josemsotov/Smart-trolley-AGO26-arduino-bridge-15/portfolio/index.html

Skip to project

SR SOTO-ROBOTICS Toggle navigation

01 SOTO-ROBOTICS R&D case study

# Smart Golf Trolley

A multidisciplinary robotic platform developed by SOTO-ROBOTICS to explore safe autonomous assistance on the golf course—from motor control and sensing to ROS 2 perception and a field-ready operator interface.

Explore the engineering ↓ Contact Jose ↗

- ROS 2Jazzy robotics stack
- 2-layerEmbedded + edge control
- Safety-ledFail-safe architecture

01 Dual LiDAR

02 RGB-D vision

03 Differential drive

Prototype development / active validation

Embedded systemsRoboticsElectronicsMechanical integrationPerceptionTest & validation Embedded systemsRoboticsElectronicsMechanical integration

02 Project overview

## Turning a trolley into a robotic platform

The objective was not simply to motorise a golf trolley. It was to create an extensible engineering platform capable of manual operation, person-following research, environmental sensing and future autonomous navigation—without losing sight of real-world safety.

The work brings together a differential-drive chassis, low-level AVR firmware, a Raspberry Pi 5 running ROS 2, multi-sensor perception, live telemetry and a purpose-built web console.

Development follows an incremental R&D process: model, integrate, bench-test, measure, diagnose and only then advance towards controlled ground trials.

01

### The challenge

Coordinate motors, noisy wheel feedback and diverse sensors across two computing layers while maintaining predictable stop behaviour.

02

### The approach

Separate deterministic hardware control from high-level robotics, connect them through a validated serial protocol and test each layer independently.

03

### The outcome

An integrated prototype with manual drive, telemetry, fused odometry, perception experiments, simulation and layered safety controls.

03 Engineering scope

## One project. Four disciplines.

01

</>

### Software & autonomy

Developed a modular Arduino C++ control layer and a ROS 2 Jazzy stack for command routing, odometry, localisation experiments, person-following and operator control.

- C++ / Arduino
- Python
- ROS 2 Jazzy
- Nav2
- Gazebo
- FastAPI

02

⚛

### Electronics & sensing

Integrated dual motor actuation with Hall and optical encoder feedback, IMU, current monitoring, GPS, RGB-D vision, upper LiDAR and a 90 FPS global-shutter camera. A second low-mounted LiDAR was prototyped and is currently displaced by the swing camera.

- Mega 2560
- Raspberry Pi 5
- MPU IMU
- ACS712
- Kinect RGB-D
- LD19 LiDAR
- ELP 90 FPS camera

03

◎

### Mechanical integration

Configured a differential-drive layout around 270 mm wheels and passive casters, then defined the robot geometry, sensor frames and collision model for physical integration and simulation.

- Drive layout
- Sensor mounting
- Wheel geometry
- URDF / Xacro
- Packaging
- Service access

04

✓

### Systems validation

Created dedicated diagnostics, repeatable encoder sweeps, motor bench routines, simulation scenarios and live dashboards to expose faults before autonomous operation.

- Bench testing
- Calibration
- Telemetry
- Fault injection
- Simulation
- Traceable results

04 Mechanical integration

## Robotics engineered around an off-the-shelf trolley

The mechanical strategy retains the practical structure of a commercially available trolley and adds purpose-designed interfaces where standard hardware cannot meet the robotic requirements.

Custom 3D-printed parts provide a rapid, adaptable route for mounting sensors, routing cables, housing electronics and aligning components. This hybrid approach reduces fabrication time while allowing the robotic package to evolve through repeated physical trials.

PHOTO 01 Full trolley overview Final project photography to be added

01

Platform integration

Overall view showing how the robotic system is incorporated into the original trolley structure.

PHOTO 02 3D-printed interfaces Mount and enclosure close-ups

02

Custom adaptation

Printed brackets and enclosures bridge the geometry between sensors, electronics and the donor trolley.

PHOTO 03 Electronics packaging Wiring and service access

03

Serviceable assembly

Controller, power and sensor connections arranged for inspection, iteration and fault finding.

01

### Reuse the proven base

The off-the-shelf trolley contributes an established frame, wheel arrangement and load-carrying function, concentrating development effort on robotic capability.

02

### Adapt without permanent tooling

3D printing enables fast geometry changes as sensor positions, cable routes and component selections are refined during prototype testing.

03

### Design for maintenance

Modular mounts and accessible electronics support inspection, replacement and controlled experimentation across the evolving platform.

05 System architecture

## Designed in layers

Time-critical motor and safety functions stay close to the hardware. Compute-intensive perception, supervision and operator tooling run on the edge computer.

Human interface

### Operator

Stadia controller
Responsive web console
Emergency stop

Commands

High-level compute

### Raspberry Pi 5

ROS 2 orchestration
Perception & following
Odometry & telemetry

115.2 kbaud

Real-time interface

### Arduino Mega

Motor PWM & direction
Encoder acquisition
Watchdog & limits

Perception

### RGB-D + dual LiDAR

Visual tracking and 2D ranging provide complementary environmental observations for follower and obstacle-gating research.

Motion feedback

### Hall + optical fusion

Two encoder technologies are compared in a shared 45 PPR domain, with weighted fusion and fail-safe fallback when they disagree.

Vehicle state

### IMU + current + GPS

Orientation, motor load and position data enrich diagnostics and support heading, localisation and protection functions.

06 Systems engineering

## From stakeholder need to verified behaviour

The trolley is treated as a system of people, software, electronics, mechanics, information and operating procedures—not as a collection of components.

A V-model and MBSE-inspired workflow connects operational needs to functions, logical architecture, physical implementation, interfaces and verification evidence. The artefacts below are reconstructed from the implemented prototype and its test record.

Scope statement: this is a preliminary engineering baseline for an R&D prototype. It is not an ISO 26262 assessment, product certification, safety case or permission for unsupervised operation.

01

### Need & CONOPS

Assist a golfer by carrying equipment, following or accepting manual commands while remaining observable and controllable during field trials.

02

### Requirements

Translate the need into measurable motion, perception, control-authority, stopping, telemetry and maintainability requirements.

03

### Functional analysis

Decompose the mission into operate, perceive, decide, move, protect, estimate, inform, verify and support functions.

04

### Architecture & interfaces

Allocate functions across the operator, web HMI, ROS 2 edge computer, embedded controller, sensors and mechanical plant.

05

### Integration & V&V

Integrate bottom-up, exercise interfaces, inject stale or invalid inputs and retain test results as objective evidence.

A System context

### Functional and physical allocation

Commands flow left to right; state, diagnostics and evidence return to the operator. The boundary includes the robot and its local edge-compute stack.

Stakeholders

#### People & external systems

- Golfer / operator
- Test engineer
- Maintainer
- Home Assistant

intent

Interaction

#### Control & information

- Physical Stadia controller
- Fairway Trolley OS
- STOP and mode requests
- Telemetry / maps / media

HTTP · evdev

Edge compute

#### Raspberry Pi 5 / ROS 2

- Authority & velocity mux
- Follower / gesture / navigation
- Odometry, EKF & perception
- Web API and observability

USB serial

Embedded control

#### Arduino Mega 2560

- Command validation & watchdog
- Differential drive conversion
- Sensor acquisition
- PWM / direction / brake / stop

I/O · power

Physical plant

#### Trolley & environment

- Two driven wheels
- Passive casters and chassis
- Golf equipment payload
- People, terrain and obstacles

Feedback path Hall + optical encodersIMUmotor currentGPSRGB-Ddual LiDAR

B Control architecture

### One authorised motion path

Multiple behaviours may propose motion, but a single arbiter selects and limits one fresh source before commands cross the embedded boundary.

Command sources

Web dead-manFresh while held

Physical StadiaManual takeover

FollowerAuthorised person track

GestureExplicit mode

Nav2Readiness + GPS gated

1Field supervisorFail-closed mode selection

2cmd_vel muxFreshness, priority and ±0.45 m/s / ±0.90 rad/s clamps

3Arduino bridge0.5 s command watchdog and serial validation

4FirmwareVelocity constraints, 1.0 s ROS timeout, heading and motor state

5ActuationTimer5 PWM, direction, brake and driver STOP lines

C

### Functional allocation

Operate

Modes, manual drive, web dead-man, speed limits and emergency request.

HMI + Stadia + field supervisor

Perceive

Person, face session, obstacles, depth, pose and high-speed swing observations.

Kinect + upper LiDAR + ELP global shutter + Coral

Decide

Control authority, target association, obstacle gating and navigation readiness.

ROS 2 supervision and behaviours

Move

Differential velocity conversion, heading correction and motor actuation.

Bridge + Arduino firmware + drivers

Estimate

Wheel odometry, encoder confidence, IMU state, GPS and mapping.

Encoder fusion + EKF + SLAM

Protect

Source timeout, command clamps, stop states, takeover and perception freshness.

Distributed software controls

Inform & verify

Live telemetry, health, maps, diagnostics, media and recorded test results.

Fairway OS + Python test tools

D

### Lifecycle evidence

1. NeedSafe robotic assistance concept
2. RequirementsDerived operating and safety baseline
3. Logical designFunctions, modes and authority model
4. Physical designPi, Mega, sensors, drivers and chassis
5. Component verificationMotor, Hall, optical, IMU, current and serial tools
6. Integration verificationROS tests, interface checks and bench sweeps
7. System validationControlled ground trials remain incomplete

Traceability rule

Need → requirement → function → component/interface → verification method → result. The current repository contains substantial test evidence, but not yet a complete approved RTM.

E Interface control

### Defined exchanges across boundaries

ID | Boundary | Exchange | Protocol / physical interface | Control or constraint
IF-01 | Operator ↔ Fairway OS | Modes, STOP, limits, telemetry, map and media | HTTP, WebSocket, responsive browser | Web joystick is dead-man; loss of fresh packets returns zero
IF-02 | Home Assistant ↔ Fairway OS | Canonical operator interface | HTTP iframe | One UI implementation; HA authentication does not protect the direct Pi URL
IF-03 | Stadia ↔ Pi | Drive axes, takeover and safety buttons | Bluetooth / Linux evdev | Takeover on connect; configured deadzones; current deployed profile does not require neutral-to-arm
IF-04 | ROS 2 nodes | Commands, state, images, scans and transforms | DDS over Zenoh; ROS topics / TF | Single output mux; source freshness and mode authority
IF-05 | Pi ↔ Arduino | Velocity, raw diagnostics and telemetry | USB ASCII serial at 115,200 baud | Line validation, bounded raw command length and independent timeouts
IF-06 | Arduino ↔ motor drivers | PWM, direction, brake and STOP | Timer5 + digital I/O | Pin-specific implementation; pin 44 requires direct OCR5C handling
IF-07 | Wheels ↔ Arduino | Rotation pulses | Hall + optical interrupts, 45 effective PPR | Hall-primary confidence logic; optical-only motion is rejected
IF-08 | IMU ↔ Arduino | Acceleration, rate, pitch and yaw | I2C, 200 Hz target | Filtering, calibration and heading feedback; tilt logic exists
IF-09 | Power path ↔ Arduino | Left/right motor current | ACS712 analogue inputs | Telemetry implemented; automatic overcurrent trip not evidenced
IF-10 | GPS ↔ Arduino/Pi | Fix, satellites and position | Serial3 at 9,600 baud / ROS NavSatFix | Navigation gated by freshness, fix and quality; antenna transform remains provisional
IF-11 | Kinect ↔ Pi | RGB, depth, body, face and tilt | USB / ROS image topics | Freshness and identity gates; not a safety-rated perception channel
IF-12 | LD19 ↔ Pi | Upper 2D range scan; provision for a lower scan | USB serial at 230,400 baud / LaserScan | Upper scan supports behaviour; the lower unit is currently disconnected and disabled
IF-13 | TF-Luna provision | Short-range distance | I2C 0x10 / 0x11 via 3.3 V adaptation | Compiled support, disabled at boot and not credited for stopping
IF-14 | ELP camera ↔ Pi | Live framing and high-speed swing video | Direct USB / V4L2 MJPEG; 640×480 preview and 1920×1080 capture at 90 FPS | Preview releases the device for a bounded 15 s master capture, then resumes while the H.264 review proxy is generated; analysis evidence only, not a safety channel

F Provisional requirements baseline

### Measurable statements and verification intent

These requirements are derived from implemented behaviour and recorded configuration. They should be reviewed with stakeholders and placed under formal change control.

ID | Provisional system requirement | Allocation | Verification | Current evidence
SYS-01 | The system shall default to a non-moving state when no authorised fresh command source is available. | Supervisor, mux, bridge, firmware | Fault injection / timeout test | Implemented; multi-layer timeout evidence, full chain timing TBC
SYS-02 | The system shall constrain commanded velocity to the approved prototype operating envelope. | Mux, Stadia node, firmware | Boundary-value test | ROS unit tests verify ±0.45 m/s and ±0.90 rad/s mux clamps
SYS-03 | The operator shall be able to cancel autonomous following through deliberate physical-controller input. | Stadia node, supervisor | Integration test | Takeover and authorisation revocation implemented
SYS-04 | Follower motion shall require a connected controller, explicit authorisation, fresh follower state and an enabled person track. | Supervisor, Stadia, follower | State-transition test | Fail-closed selection has automated tests
SYS-05 | Forward follower motion shall be inhibited when required obstacle observations are stale, unknown or blocked. | Follower obstacle gate | Unit + controlled obstacle test | Core unit tests pass; physical coverage and stopping distance TBC
SYS-06 | The system shall report command, motor, encoder, IMU, GPS, perception and service freshness to the operator. | Bridge, web server, HMI | Interface inspection | Live WebSocket dashboard implemented
SYS-07 | The embedded controller shall set motor demand to zero within 1.0 s of a lost ROS velocity command. | Arduino firmware | Timed disconnect test | Firmware timeout implemented; measured end-to-end stop TBC
SYS-08 | The system shall preserve diagnostic evidence sufficient to reproduce calibration and integration decisions. | Test tools and repository | Configuration audit | Extensive records exist; formal configuration baseline remains incomplete

G Preliminary safety engineering

### Credit controls only when evidence supports them

The assessment uses qualitative severity and likelihood for prioritisation. ISO 26262 HARA concepts inform the structure, but ASIL is deliberately not assigned: this trolley is not being assessed as a road-vehicle item, operational exposure is not quantified, and controllability data is unavailable.

SF-01 · credited prototype control

#### Fail-closed command chain

Mode gating, single-source arbitration, source freshness, Pi watchdog and firmware timeout drive demand to zero after communication loss.

Evidence: code + ROS unit tests. End-to-end stopping time and distance still require measurement.

SF-02 · credited prototype control

#### Manual takeover

Physical Stadia movement revokes follower authorisation, sends zero and transfers authority to manual control.

Evidence: implemented logic. Human-factors validation remains open.

SF-03 · credited prototype control

#### Velocity limiting and ramping

Command clamps, deadzones, acceleration/deceleration ramps and stop-before-reversal reduce abrupt or excessive demand.

Evidence: configuration + unit tests. Safe limits depend on mass, slope and surface.

SF-04 · partial credit

#### Obstacle and target gating

Follower logic requires fresh LiDAR/depth observations and uses target continuity and visual identity checks.

Gap: blind zones, environmental performance and physical stopping distance are not validated.

SF-05 · monitoring only

#### Velocity guard and current sensing

The guard detects conflicting publishers, motion while stopped and limit violations; ACS712 channels expose motor current.

Gap: the configured guard is monitor-only and no automatic overcurrent shutdown is evidenced.

SF-06 · not credited

#### Tilt / balance response

Firmware contains tilt thresholds, correction and emergency-stop logic, but the production ROS controller repeatedly commands balance off.

Gap: behaviour is not a validated safety function in the deployed operating configuration.

SF-07 · not evidenced

#### Independent emergency stop

The red web STOP and software stop chain are useful operational controls.

Gap: no independent hardwired mushroom, safety relay or motor-power contactor is evidenced in the reviewed baseline.

Preliminary risk priority CriticalHighMediumLow

Priority combines credible harm severity with qualitative likelihood before additional mitigation. It is not an ASIL or certified risk rating.

ID | Hazardous event | Potential effect | Existing controls | Key gap / recommended action | Priority
HZ-01 | Unintended motion or failure to stop | Impact, trapping or trolley runaway | Authority model, mux zero, multiple watchdogs, software STOP | Add independent hardwired E-stop and power isolation; measure worst-case stop time/distance on representative load and slope | Critical
HZ-02 | Forward collision during follower operation | Person struck or equipment/property damage | Upper LiDAR, depth freshness, obstacle gate, speed limit | Validate field of view, detection probability and braking envelope across clothing, sunlight, rain and terrain | High
HZ-03 | Reverse or low-obstacle collision | Foot/ankle impact, caster obstruction or tip | Unknown-rear logic can inhibit retreat in obstacle core | Integrate and validate lower/rear sensing or contact bumpers; the prototype lower LiDAR is currently displaced | High
HZ-04 | Wrong-person acquisition or target jump | Unexpected trajectory into people or hazards | Face session, visual/LiDAR gating, continuity checks, controller authorisation | Quantify false accept/switch rates; require safe reacquisition and operator confirmation after track loss | High
HZ-05 | Tip, rollaway or unstable behaviour on slope | Crush/impact, damaged equipment | Low speed, IMU telemetry, firmware tilt logic | Define slope/payload limits, centre-of-gravity envelope, parking restraint and validated static/dynamic stability tests | High
HZ-06 | Electrical overcurrent, short circuit or battery thermal event | Fire, burns or loss of control | Current telemetry; motor-driver stop lines | Confirm battery chemistry, BMS, fuse, contactor, cable protection, enclosure and automatic trip architecture | Critical
HZ-07 | Unauthorised or malformed network command | Unexpected mode or motion request | Input ranges, source mux and local-network deployment | Add authenticated API, TLS or trusted reverse proxy; restrict raw diagnostics and segment the robot network | High
HZ-08 | Sensor data stale, biased or geometrically misregistered | Incorrect localisation, obstacle decision or heading | Freshness checks, confidence logic and TF model | Complete sensor calibration, lower-LiDAR pose and GPS antenna transform; add plausibility/fault-injection tests | High
HZ-09 | Unexpected movement during maintenance or diagnostic test | Hand injury, impact or entanglement | Warnings, explicit test modes, zero defaults and documented bench practice | Use keyed maintenance enable, wheel-off-ground fixture, exclusion zone and two-person test procedure | High

H

### Risk-reduction roadmap

1. Hardware safe stateDefine and implement independent E-stop, power isolation, braking behaviour and restart interlock.
2. Motion envelopeMeasure loaded stopping distance, slope stability, traction and caster behaviour; derive validated limits.
3. Protective sensingClose rear/low-obstacle coverage and validate perception under representative outdoor conditions.
4. Electrical protectionBaseline battery/BMS/fusing/contactors, current trip thresholds, thermal monitoring and wiring protection.
5. Secure control planeAuthenticate remote commands, isolate diagnostic routes and document the trust boundary.
6. Safety evidenceCreate an approved requirements traceability matrix, interface control documents, hazard log and witnessed V&V procedures.

I

### Assumptions & TBC register

No unsupported value is treated as fact. The following must be measured or confirmed before detailed design limits can be justified:

- Total mass, payload range and centre of gravity
- Motor, gearbox, driver and braking ratings
- Battery chemistry, capacity and protection architecture
- Maximum slope, cross-slope, surface and weather envelope
- Stopping distance and fault-tolerant time interval
- Full sensor coverage, blind zones and environmental limits
- Mechanical strength, ingress protection and EMC performance
- Mission duration, duty cycle, service life and reliability target
- Operator population, training and controllability evidence
- Applicable product, machinery, radio and battery regulations

07 Software design

## From a deterministic loop to a robotics ecosystem

CONTROL_FLOW.cpp

01  read_serial_commands();
02  update_imu_and_current();
03
04  if (command_is_fresh) {
05    constrain_velocity();
06    apply_heading_correction();
07    drive_differential_motors();
08  } else {
09    safe_stop();
10  }
11
12  publish_telemetry();

01

### Modular firmware

Compile-time feature flags keep the AVR build configurable while a cooperative superloop avoids blocking the safety path.

02

### ROS 2 command supervision

A velocity multiplexer separates manual, gesture, follower and navigation sources so control authority is explicit.

03

### Field observability

A FastAPI and WebSocket interface exposes modes, sensors, motor state, maps and diagnostics from any device on the robot network.

Manual control Verified production mapping

### One controller. Explicit authority.

The physical Stadia controller provides immediate manual takeover and safety actions. Deliberate left-stick movement cancels follower operation; connection takeover sends an initial zero command before manual demand is accepted.

The D-pad, shoulder, Assistant and Capture controls are intentionally unassigned in the production ROS 2 node.

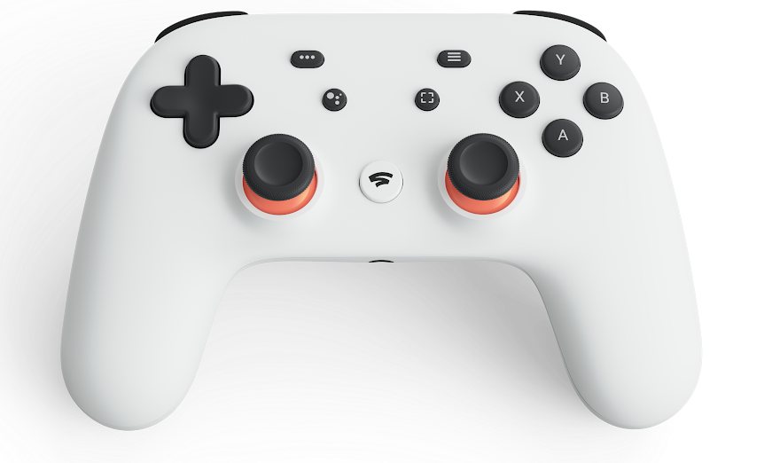
[picture p1: portfolio/stadia-controller.png]
White Google Stadia controller used for manual Smart Golf Trolley operation.
 Open full-size controller image ↗

- Left stickDrive and cancel FOLLOWER
- AManual Stadia control
- BSTOP and cancel FOLLOWER
- XToggle Kinect tilt mode
- Right stickKinect tilt when X is active
- YBalance OFF and STOP
- MenuSystem OFF, STOP and status

08 Safety by design

## Stop is a system function.

Safety is implemented across the control chain rather than delegated to a single switch or software node.

- ✓ Arduino command watchdog with a 0.5 s timeout
- ✓ Constrained speed, angular rate, PWM and acceleration
- ✓ Manual control priority, deadzones and zero-demand takeover
- ✓ Explicit authorisation before follower mode can move
- ✓ Tilt monitoring, current telemetry and motor stop states
- ✓ Conservative bench validation before ground trials

09 Development & validation

## Evidence over assumption

45PPR effective encoder domain

200HzIMU acquisition target

20HzEncoder request cycle

0.5sCommand watchdog

### A traceable engineering loop

Special-purpose sketches and Python tools isolate motors, sensors and communications. Recorded sweeps compare Hall and optical counts, identify unreliable operating regions and inform the firmware configuration.

Gazebo models reproduce the drive geometry and sensor frames before higher-level behaviours are exercised on hardware. Results and limitations are documented as part of the development record.

Current status

Integrated R&D prototype. Core subsystems and safety paths have been bench-tested; calibration and controlled ground validation remain active engineering work. No claim of production readiness is made.

10 Engineering journey

## Built through iteration

1. Foundation

### Motor interface & control

  Differential motor control, pin mapping, direction logic and safe-stop behaviour established on the Arduino platform.
2. Instrumentation

### Feedback & diagnostics

  Hall, optical, IMU and current sensing integrated with dedicated test routines and serial telemetry.
3. Connectivity

### ROS 2 bridge

  Bidirectional serial protocol connected deterministic firmware to Raspberry Pi robotics software.
4. Intelligence

### Perception & supervision

  RGB-D, LiDAR, gesture and face-session experiments added within an explicit control-authority model.
5. Field engineering

### Operator UI & validation

  Live web tools, simulations and structured test records now support progressive system integration.

11 Role & contribution

## End-to-end engineering by SOTO-ROBOTICS

Led by Jose M Soto V through SOTO-ROBOTICS, this project demonstrates practical consultancy R&D across embedded systems, robotics software, electronic integration, mechanical packaging, troubleshooting and verification.

Responsibilities span system architecture, component integration, firmware and Python development, ROS 2 implementation, diagnostic tooling, test execution and technical documentation.

12 Engineering consultancy

## Have a product that needs to move, sense or think?

SOTO-ROBOTICS provides engineering consultancy for robotics, embedded systems, automation, prototyping and multidisciplinary product development.

Start a conversation ↗

SRSOTO-ROBOTICS

Engineering consultancy · R&D · Robotics · Embedded systems

Technical baseline: portfolio-v1.0.0 (https://github.com/josemsotov/Smart-trolley-AGO26-arduino-bridge-15/tree/portfolio-v1.0.0)

Contact josemsotov@gmail.com

© 2026 SOTO-ROBOTICS
