josemsotov/Smart-trolley-AGO26-arduino-bridge-15/simulation_ws/results/manual_encoder/filter_ab_20260911.md

# Filter A/B - 2026-09-11

Firmware adds `j leftscale 50..100`, motor-stopped-only runtime scaling of
left Hall-derived adaptive opto window. Boot default100 preserves prior
algorithm. Bootstrap and lower/upper clamps unchanged. Right unaffected.
Flash66790 bytes; RAM7020 (1172 free, low-memory warning). avrdude verified.
Pre-change flash: /home/josemsotov/robot_backups/smooth_20260910_4falka/original.hex.

Initial run222652 aborted before motion on stale idle telemetry. Added zero
handshake before each trial; safety age limits unchanged.

Settled t3..7.8s windows, demand15, smooth floor18, PI/heading/balance off:

| Scale | Trial | Hall | Opto | Difference relative Hall |
|---|---|---:|---:|---:|
| 100 | 1 | 134 | 127 | -5.22% |
| 100 | 2 | 132 | 125 | -5.30% |
| 80 | 1 | 134 | 125 | -6.72% |
| 80 | 2 | 134 | 126 | -5.97% |

Files222721=100%;222800=80%. Raw/accepted/rejected full-stage totals are
in .edges.json. Right counters zero. 80% does NOT improve concordance;
restore100, do not adopt candidate. Counts do not establish whether Hall
has extra pulses or opto misses true slots. Need independent timing/physical
reference rather than tuning only to force equality.
Final normal service active, PWM/RPM zero; smooth18 runtime restored;
leftscale100 acknowledged. No permanent calibration change selected.
