josemsotov/Smart-trolley-AGO26-arduino-bridge-15/simulation_ws/results/obstacle_bench/RESULT_20260911_232351.md

# First observed obstacle-triggered motorized bench stop

Temporary gesture node suspension authorized; camera/depth retained. Same
20s maximum and smooth18/scale100 profile; no threshold changes.
Run obstacle_armed_20260911_232351.json: first latch at t21.378867s,
depth0.798m, front lidar1.151m, command becomes zero. Prior motor snapshot
PWM18/RPM55 at latch, followed by zero motor telemetry. Trigger was Kinect
crossing0.8m, NOT simultaneous confirmation from both sensors. LiDAR and
Kinect both observed approach before this frame but did not agree at trigger.
Object subsequently removed (>1.2m); latch remained obstacle and no command
restart through t55s. Timeout did not cause the initial stop.

Validates one bench detection-to-stop event, not independent LiDAR stopping,
all obstacle geometries, sensor-loss response in hardware, stopping distance,
or ground autonomy. RPM telemetry is not an independent braking measurement.
Main stack restarted on exit (gesture node restored); smooth18/scale100
reapplied while stationary. Gate remains temporary, NOT enabled for Stadia.
