josemsotov/Smart-trolley-AGO26-arduino-bridge-15/simulation_ws/results/smooth_20260910/EXCLUDED_TRIALS.md

# Capturas excluidas

- `stadia_20260910_121835.json`: prueba invalida. El usuario confirmo que
  una rueda estaba rozando el banco. No utilizar para evaluar suavidad,
  fuerza, asimetria ni ajustar parametros de control. Se conserva el archivo
  solo como registro; la siguiente captura se realiza tras liberar las ruedas.
