josemsotov/Smart-trolley-AGO26-arduino-bridge-15/encoder_calibration_reports/controller_pwm_profile_20260827.csv

pwm | repeat | side | opto_channel | hall | opto | expected_opto | signed_error_pct | ratio_opto_per_hall
10 | 1 | L | OL | 14 | 14 | 14.0 | 0.0 | 1.0
10 | 1 | R | OR | 14 | 14 | 14.0 | 0.0 | 1.0
10 | 2 | L | OL | 14 | 16 | 14.0 | 14.285714285714286 | 1.1428571428571428
10 | 2 | R | OR | 13 | 14 | 13.0 | 7.6923076923076925 | 1.0769230769230769
10 | 3 | L | OL | 14 | 23 | 14.0 | 64.28571428571429 | 1.6428571428571428
10 | 3 | R | OR | 15 | 14 | 15.0 | -6.666666666666667 | 0.9333333333333333
15 | 1 | L | OL | 25 | 27 | 25.0 | 8.0 | 1.08
15 | 1 | R | OR | 24 | 25 | 24.0 | 4.166666666666667 | 1.0416666666666667
15 | 2 | L | OL | 23 | 27 | 23.0 | 17.391304347826086 | 1.173913043478261
15 | 2 | R | OR | 24 | 24 | 24.0 | 0.0 | 1.0
15 | 3 | L | OL | 25 | 26 | 25.0 | 4.0 | 1.04
15 | 3 | R | OR | 24 | 35 | 24.0 | 45.833333333333336 | 1.4583333333333333
20 | 1 | L | OL | 33 | 34 | 33.0 | 3.0303030303030303 | 1.0303030303030303
20 | 1 | R | OR | 34 | 33 | 34.0 | -2.9411764705882355 | 0.9705882352941176
20 | 2 | L | OL | 33 | 33 | 33.0 | 0.0 | 1.0
20 | 2 | R | OR | 34 | 35 | 34.0 | 2.9411764705882355 | 1.0294117647058822
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
