josemsotov/Smart-trolley-AGO26-arduino-bridge-15/encoder_calibration_reports/encoder_both_45ppr_full_20260825.csv

pwm | repeat | side | opto_channel | hall | opto | expected_opto | signed_error_pct | ratio_opto_per_hall
0 | 1 | L | OL | 0 | 0 | 0.0
0 | 1 | R | OR | 0 | 0 | 0.0
0 | 2 | L | OL | 0 | 0 | 0.0
0 | 2 | R | OR | 0 | 0 | 0.0
0 | 3 | L | OL | 0 | 0 | 0.0
0 | 3 | R | OR | 0 | 0 | 0.0
10 | 1 | L | OL | 14 | 14 | 14.0 | 0.0 | 1.0
10 | 1 | R | OR | 15 | 14 | 15.0 | -6.666666666666667 | 0.9333333333333333
10 | 2 | L | OL | 14 | 14 | 14.0 | 0.0 | 1.0
10 | 2 | R | OR | 14 | 14 | 14.0 | 0.0 | 1.0
10 | 3 | L | OL | 14 | 15 | 14.0 | 7.142857142857143 | 1.0714285714285714
10 | 3 | R | OR | 14 | 14 | 14.0 | 0.0 | 1.0
15 | 1 | L | OL | 23 | 24 | 23.0 | 4.3478260869565215 | 1.0434782608695652
15 | 1 | R | OR | 25 | 25 | 25.0 | 0.0 | 1.0
15 | 2 | L | OL | 25 | 25 | 25.0 | 0.0 | 1.0
15 | 2 | R | OR | 25 | 31 | 25.0 | 24.0 | 1.24
15 | 3 | L | OL | 24 | 24 | 24.0 | 0.0 | 1.0
15 | 3 | R | OR | 25 | 25 | 25.0 | 0.0 | 1.0
20 | 1 | L | OL | 33 | 34 | 33.0 | 3.0303030303030303 | 1.0303030303030303
20 | 1 | R | OR | 34 | 34 | 34.0 | 0.0 | 1.0
20 | 2 | L | OL | 33 | 34 | 33.0 | 3.0303030303030303 | 1.0303030303030303
20 | 2 | R | OR | 34 | 37 | 34.0 | 8.823529411764707 | 1.088235294117647
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
