josemsotov/Smart-trolley-AGO26-arduino-bridge-15/encoder_calibration_reports/encoder_both_full_20260825.csv

pwm | repeat | side | opto_channel | hall | opto | expected_opto | signed_error_pct | ratio_opto_per_hall
0 | 1 | L | OL | 0 | 0 | 0.0
0 | 1 | R | OR | 0 | 0 | 0.0
0 | 2 | L | OL | 0 | 0 | 0.0
0 | 2 | R | OR | 0 | 0 | 0.0
0 | 3 | L | OL | 0 | 0 | 0.0
0 | 3 | R | OR | 0 | 0 | 0.0
10 | 1 | L | OL | 14 | 0 | 18.666666666666664 | -100.0 | 0.0
10 | 1 | R | OR | 11 | 12 | 14.666666666666666 | -18.18181818181818 | 1.0909090909090908
10 | 2 | L | OL | 14 | 0 | 18.666666666666664 | -100.0 | 0.0
10 | 2 | R | OR | 13 | 13 | 17.333333333333332 | -24.999999999999993 | 1.0
10 | 3 | L | OL | 14 | 0 | 18.666666666666664 | -100.0 | 0.0
10 | 3 | R | OR | 12 | 12 | 16.0 | -25.0 | 1.0
20 | 1 | L | OL | 33 | 0 | 44.0 | -100.0 | 0.0
20 | 1 | R | OR | 32 | 32 | 42.666666666666664 | -24.999999999999996 | 1.0
20 | 2 | L | OL | 33 | 0 | 44.0 | -100.0 | 0.0
20 | 2 | R | OR | 32 | 33 | 42.666666666666664 | -22.656249999999996 | 1.03125
20 | 3 | L | OL | 33 | 0 | 44.0 | -100.0 | 0.0
20 | 3 | R | OR | 32 | 31 | 42.666666666666664 | -27.343749999999996 | 0.96875
30 | 1 | L | OL | 54 | 0 | 72.0 | -100.0 | 0.0
30 | 1 | R | OR | 53 | 52 | 70.66666666666666 | -26.41509433962263 | 0.9811320754716981
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
