josemsotov/Smart-trolley-AGO26-arduino-bridge-15/encoder_calibration_reports/encoder_both_full_repeat_20260825.csv

pwm | repeat | side | opto_channel | hall | opto | expected_opto | signed_error_pct | ratio_opto_per_hall
0 | 1 | L | OL | 0 | 0 | 0.0
0 | 1 | R | OR | 0 | 0 | 0.0
0 | 2 | L | OL | 0 | 0 | 0.0
0 | 2 | R | OR | 0 | 0 | 0.0
0 | 3 | L | OL | 0 | 0 | 0.0
0 | 3 | R | OR | 0 | 0 | 0.0
10 | 1 | L | OL | 11 | 11 | 14.666666666666666 | -25.0 | 1.0
10 | 1 | R | OR | 13 | 12 | 17.333333333333332 | -30.769230769230766 | 0.9230769230769231
10 | 2 | L | OL | 12 | 11 | 16.0 | -31.25 | 0.9166666666666666
10 | 2 | R | OR | 12 | 12 | 16.0 | -25.0 | 1.0
10 | 3 | L | OL | 7 | 39 | 9.333333333333332 | 317.85714285714295 | 5.571428571428571
10 | 3 | R | OR | 12 | 12 | 16.0 | -25.0 | 1.0
15 | 1 | L | OL | 25 | 12 | 33.33333333333333 | -64.0 | 0.48
15 | 1 | R | OR | 23 | 22 | 30.666666666666664 | -28.260869565217384 | 0.9565217391304348
15 | 2 | L | OL | 21 | 26 | 28.0 | -7.142857142857143 | 1.2380952380952381
15 | 2 | R | OR | 23 | 24 | 30.666666666666664 | -21.739130434782602 | 1.0434782608695652
15 | 3 | L | OL | 1 | 0 | 1.3333333333333333 | -99.99999999999999 | 0.0
15 | 3 | R | OR | 24 | 23 | 32.0 | -28.125 | 0.9583333333333334
20 | 1 | L | OL | 0 | 0 | 0.0
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
