josemsotov/Smart-trolley-AGO26-arduino-bridge-15/encoder_calibration_reports/encoder_both_intermediate_20260825.csv

pwm | repeat | side | opto_channel | hall | opto | expected_opto | signed_error_pct | ratio_opto_per_hall
15 | 1 | L | OL | 24 | 0 | 32.0 | -100.0 | 0.0
15 | 1 | R | OR | 23 | 25 | 30.666666666666664 | -18.47826086956521 | 1.0869565217391304
15 | 2 | L | OL | 25 | 0 | 33.33333333333333 | -100.0 | 0.0
15 | 2 | R | OR | 23 | 23 | 30.666666666666664 | -24.999999999999993 | 1.0
15 | 3 | L | OL | 24 | 0 | 32.0 | -100.0 | 0.0
15 | 3 | R | OR | 23 | 23 | 30.666666666666664 | -24.999999999999993 | 1.0
25 | 1 | L | OL | 44 | 0 | 58.666666666666664 | -100.0 | 0.0
25 | 1 | R | OR | 43 | 43 | 57.33333333333333 | -24.999999999999993 | 1.0
25 | 2 | L | OL | 44 | 0 | 58.666666666666664 | -100.0 | 0.0
25 | 2 | R | OR | 43 | 43 | 57.33333333333333 | -24.999999999999993 | 1.0
25 | 3 | L | OL | 44 | 0 | 58.666666666666664 | -100.0 | 0.0
25 | 3 | R | OR | 42 | 43 | 56.0 | -23.214285714285715 | 1.0238095238095237
35 | 1 | L | OL | 63 | 0 | 84.0 | -100.0 | 0.0
35 | 1 | R | OR | 62 | 65 | 82.66666666666666 | -21.370967741935473 | 1.0483870967741935
35 | 2 | L | OL | 63 | 0 | 84.0 | -100.0 | 0.0
35 | 2 | R | OR | 62 | 63 | 82.66666666666666 | -23.79032258064515 | 1.0161290322580645
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
