josemsotov/Smart-trolley-AGO26-arduino-bridge-15/Configuration.h

#define CONFIGURATION_H
#define ENABLE_HALL_SENSORS           // Activar sensores Hall
#define ENABLE_OPTO_ENCODERS           // Activar OptoEncoders en D2/D3
#if defined(ENABLE_HALL_SENSORS) && defined(ENABLE_OPTO_ENCODERS)
  #define ENABLE_DUAL_SENSOR_MODE     // Usar ambos sensores simultáneamente
#endif
#define ENABLE_MPU9250                // Activar sensor MPU9250/6500
  #define ENABLE_MPU_AUTO_CALIBRATION // Calibración automática al inicio
  #define ENABLE_MPU_HEADING_CONTROL
  #define HEADING_GYRO_SIGN             -1.0f
  #define HEADING_HOLD_KP                0.035f
  #define HEADING_RATE_KP                0.30f
  #define HEADING_MAX_CORRECTION_RAD_S   0.35f
  #define HEADING_ANGULAR_DEADBAND_RAD_S 0.04f
  #define HEADING_LINEAR_ACTIVE_M_S      0.03f
  #define HEADING_ERROR_DEADBAND_DEG     0.8f
  #define HEADING_REVERSE_HOLD_KP         0.012f
  #define HEADING_REVERSE_RATE_KP         0.10f
  #define HEADING_REVERSE_MAX_RAD_S       0.10f
  #define HEADING_REVERSE_DEADBAND_DEG    2.0f
  #define HEADING_GYRO_FILTER_ALPHA      0.18f
  #define HEADING_GYRO_BIAS_RAD_S       -0.00024f
  #define HEADING_GYRO_NOISE_RAD_S       0.004f
#define ENABLE_HOVERBOARD_MODE        // Activar balance anti-caída
  #define HOVERBOARD_KP               0.025f  // m/s / °
  #define HOVERBOARD_KD               0.002f  // m/s / (°/s)
  #define HOVERBOARD_DEAD             1.5f    // ° — sin corrección bajo este umbral
  #define HOVERBOARD_FRONT_LIMIT_DEG  35.0f   // °
  #define HOVERBOARD_REAR_LIMIT_DEG   35.0f   // °
  #define HOVERBOARD_COMP_ALPHA       0.98f
  #define HOVERBOARD_PITCH_SIGN       1.0f
#define ENABLE_CURRENT_SENSORS        // ACS712-20A en línea de potencia de cada motor
  #define ACS712_SENSITIVITY_VA   0.100f    // ACS712-20A por defecto
  #define ACS712_FILTER_ALPHA     0.15f
#define ENABLE_AUX_SERVO
  #define AUX_SERVO_MODEL_SG90
  #if defined(AUX_SERVO_MODEL_SG90) && defined(AUX_SERVO_MODEL_MG996R)
    #error "Selecciona solo un modelo de servo auxiliar"
  #elif !defined(AUX_SERVO_MODEL_SG90) && !defined(AUX_SERVO_MODEL_MG996R)
    #error "Selecciona un modelo de servo auxiliar"
  #endif
  #define AUX_SERVO_MIN_ANGLE       0
  #define AUX_SERVO_MAX_ANGLE     180
  #define AUX_SERVO_START_ANGLE     0
    #define AUX_SERVO_MODEL_NAME       "SG90"
    #define AUX_SERVO_TOGGLE_ANGLE     180
    #define AUX_SERVO_MIN_PULSE_US    1000
    #define AUX_SERVO_MAX_PULSE_US    2165
  #define AUX_SERVO_RELEASE_DELAY_MS 1000UL
  #define AUX_SERVO_SLEW_STEP_US       3U
  #define AUX_SERVO_SLEW_INTERVAL_MS   5UL
#define ENABLE_GPS                    // Activar GPS fisico del robot
#define GPS_BAUD_RATE                 9600
#define GPS_REPORT_INTERVAL_MS        1000
#define ENABLE_TF_LUNA
#define TF_LUNA_ADDR_1                0x10
#define TF_LUNA_ADDR_2                0x11
#define TF_LUNA_WAIT_MS               100UL
#define TF_LUNA_RETRY_MS              1000UL
#define TF_LUNA_STALE_MS              500UL
#define ENABLE_ROS2_BRIDGE              // Activar bridge ROS2
  #define ROS2_AUTO_START             // Auto-iniciar bridge al boot
#define ENABLE_SERIAL_COMMANDS        // Activar comandos por puerto serie
  #define ENABLE_COMMAND_HELP         // Sistema de ayuda de comandos
#define ENABLE_MOTOR_TESTS            // Funciones de prueba de motores
#define ENABLE_HARDWARE_TESTS         // Pruebas de hardware (sensores, pines)
#define ENABLE_SYSTEM_STATUS          // Información de estado del sistema
#ifdef ENABLE_DIFFERENTIAL_CONTROL
  #define DIFFERENTIAL_MIN_PWM  10    // PWM mínimo para giros
  #define DIFFERENTIAL_MAX_PWM  255   // Rango PWM completo de 8 bits
  #define DIFFERENTIAL_TIMEOUT  5000  // Timeout giros automáticos (ms)
#endif
  #define PPR_HALL_SENSORS      45    // Pulsos por revolución sensores Hall
  #define PPR_OPTO_ENCODERS     45    // PPR efectivos medidos: relacion 1:1 contra Hall de 45 PPR
  #define OPTO_FILTER_US       6000UL // Calibrado: mejor error Hall/opto con motores energizados
  #define ENABLE_ADAPTIVE_OPTO_FILTER
  #define OPTO_FILTER_LEFT_MIN_US   2500UL
  #define OPTO_FILTER_RIGHT_MIN_US  2500UL
  #define OPTO_FILTER_MAX_US       40000UL
  #define OPTO_FILTER_LEFT_HALL_PERMILLE  450UL
  #define OPTO_FILTER_RIGHT_HALL_PERMILLE 520UL
  #define ENCODER_FUSION_MAX_ERROR_PERMILLE 120UL
  #define ENCODER_FUSION_UPDATE_MS          100UL
  #define SERIAL_BAUD_RATE      115200  // Velocidad puerto serie
  #define COMMAND_BUFFER_SIZE   50      // Tamaño buffer comandos
  #define RESPONSE_DELAY        10      // Delay entre respuestas (ms)
  #define DEBUG_PRINT(...)
  #define DEBUG_PRINTLN(...)
  #define HELP_COMMAND(cmd, desc) printHelpCommand(cmd, desc)
#ifdef ENABLE_DIFFERENTIAL_CONTROL
    #error "DIFFERENTIAL_CONTROL requiere DUAL_CROSSING_CONTROL activado"
#endif
#if !defined(ENABLE_HALL_SENSORS) && !defined(ENABLE_OPTO_ENCODERS)
  #error "Debe activar al menos un tipo de sensor (HALL o OPTO)"
#endif
