josemsotov/Smart-trolley-AGO26-arduino-bridge-15/Motor_Control.h

/**
 * MOTOR-INTERFACE-V-13 MOTOR CONTROL
 * Smart Golf Trolley - Control básico de motores
 * 
 * ╔═══════════════════════════════════════════════════════════════════════╗
 * ║  ⚠️  ADVERTENCIA CRÍTICA - NO MODIFICAR LÓGICA DE MOTORES  ⚠️        ║
 * ╠═══════════════════════════════════════════════════════════════════════╣
 * ║                                                                       ║
 * ║  Las funciones setLeftMotor() y setRightMotor() están CALIBRADAS    ║
 * ║  y VERIFICADAS para funcionar correctamente en LAZO ABIERTO.        ║
 * ║                                                                       ║
 * ║  ❌ NO CAMBIAR:                                                       ║
 * ║     - Lógica de dirección (HIGH/LOW en pines DIR)                   ║
 * ║     - Lógica de STOP (FLOAT=enable, LOW=disable)                    ║
 * ║     - Lógica de BRAKE (HIGH=brake, LOW=release)                     ║
 * ║     - Mapeo de pines                                                 ║
 * ║                                                                       ║
 * ║  ✅ Si hay problemas de dirección en control PID:                    ║
 * ║     - Corregir en PID_Control.h (cinemática diferencial)            ║
 * ║     - NO modificar Motor_Control.h                                   ║
 * ║                                                                       ║
 * ║  📅 Verificado funcionando correctamente: 2025-10-12                ║
 * ║                                                                       ║
 * ╚═══════════════════════════════════════════════════════════════════════╝
 */

#ifndef MOTOR_CONTROL_H
#define MOTOR_CONTROL_H

//===========================================================================
//==================== DECLARACIONES FORWARD ==============================
//===========================================================================

// Función definida en Core_Functions.h
void emergencyStop();

//===========================================================================
//======================= VARIABLES DE CONTROL DE MOTORES =================
//===========================================================================

/**
 * ESTADOS DE LOS MOTORES
 */
struct MotorState {
  int pwm;              // Valor PWM actual (0-255)
  bool direction;       // Dirección: true=adelante, false=atrás
  bool stopped;         // Estado STOP
  bool braked;          // Estado BRAKE
  bool enabled;         // Motor habilitado
};

MotorState leftMotor  = {0, true,  true, true, false};
MotorState rightMotor = {0, false, true, true, false};  // direction=false: DIR electrico invertido

/**
 * LÍMITES DE SEGURIDAD
 */
#define MIN_PWM_VALUE          10    // Umbral de arranque; no limita el extremo superior
#define MAX_PWM_VALUE          255   // Rango completo de Timer5 / analogWrite (8 bits)
// Motor derecho: umbral re-calibrado 2026-07-07 con ruedas 0.27m.
// Caracterización confirmó motor gira desde PWM=20. Umbral 25 = margen seguro.
#define MIN_PWM_RIGHT_WORKING  10    // Recalibrado 2026-08-04: giro continuo desde PWM=10
#define EMERGENCY_STOP_TIME  300000  // Tiempo máximo sin comando (ms) - 5 minutos

// ── Timer5 PWM directo ───────────────────────────────────────────────────
// analogWrite en pines 44/45/46 (Timer5 Ch C/B/A) falla si el timer no está
// inicializado con los 3 canales activos. Esta función fuerza la configuración
// una vez y escribe OCR directamente, evitando el bug de Arduino core.
void initTimer5PWM() {
  // Fast PWM 8-bit, prescaler 64 (~977 Hz), los 3 canales no-inversor
  TCCR5A = (1<<COM5A1)|(1<<COM5B1)|(1<<COM5C1)|(1<<WGM50);
  TCCR5B = (1<<WGM52)|(1<<CS51)|(1<<CS50);
  OCR5A = OCR5B = OCR5C = 0;
  pinMode(44, OUTPUT);  // OC5C - motor derecho
  pinMode(45, OUTPUT);  // OC5B
  pinMode(46, OUTPUT);  // OC5A - motor izquierdo
}

// Escribe PWM en cualquier pin; pines 44/45/46 usan OCR directo.
// IMPORTANTE: re-habilita los bits COM cada vez para contrarrestar que
// analogWrite(pin,0) / digitalWrite los limpia vía turnOffPWM().
inline void motor_pwm_write(uint8_t pin, uint8_t value) {
  if (pin == 44) {
    TCCR5A |= (1 << COM5C1);  // reconectar OC5C al timer
    OCR5C = value;
  } else if (pin == 45) {
    TCCR5A |= (1 << COM5B1);
    OCR5B = value;
  } else if (pin == 46) {
    TCCR5A |= (1 << COM5A1);  // reconectar OC5A al timer
    OCR5A = value;
  } else {
    analogWrite(pin, value);
  }
}

// Forward declaration: rightHallTotal se define en Hall_Sensors.h (incluido después)
#ifdef ENABLE_HALL_SENSORS
extern volatile uint32_t rightHallTotal;
#endif

unsigned long lastCommandTime = 0;
bool safetyCheckEnabled = true;  // Variable para habilitar/deshabilitar safety check

//===========================================================================
//======================= FUNCIONES DE INICIALIZACIÓN ======================
//===========================================================================

/**
 * INICIALIZAR PINES DE MOTORES
 */
void initializeMotorPins() {
  // Configurar pines de control de motores como salidas
  pinMode(PWM_LEFT_MOTOR, OUTPUT);
  pinMode(DIR_LEFT_MOTOR, OUTPUT);
  pinMode(BRAKE_LEFT_MOTOR, OUTPUT);
  
  pinMode(PWM_RIGHT_MOTOR, OUTPUT);
  pinMode(DIR_RIGHT_MOTOR, OUTPUT);
  pinMode(BRAKE_RIGHT_MOTOR, OUTPUT);
  
  // *** ESTADO INICIAL: MOTORES INHABILITADOS (ESTÁTICO) ***
  // FORZAR STOP pins en LOW = DISABLE/MOTORES INHABILITADOS
  pinMode(STOP_LEFT_MOTOR, OUTPUT);
  digitalWrite(STOP_LEFT_MOTOR, LOW);   // LOW = DISABLE
  delay(10);  // Pequeña pausa para asegurar el estado
  pinMode(STOP_RIGHT_MOTOR, OUTPUT);
  digitalWrite(STOP_RIGHT_MOTOR, LOW);  // LOW = DISABLE
  delay(10);  // Pequeña pausa para asegurar el estado
  
  // VERIFICAR ESTADO (forzar LOW otra vez para asegurar)
  digitalWrite(STOP_LEFT_MOTOR, LOW);   // FORZAR LOW
  digitalWrite(STOP_RIGHT_MOTOR, LOW);  // FORZAR LOW
  
  // Inicializar Timer5 para PWM en pines 44/45/46 (fuerza los 3 canales activos)
  initTimer5PWM();

  // Estado inicial: frenos activados por seguridad
  pinMode(BRAKE_LEFT_MOTOR, OUTPUT);
  digitalWrite(BRAKE_LEFT_MOTOR, HIGH);  // HIGH = BRAKE ACTIVO
  pinMode(BRAKE_RIGHT_MOTOR, OUTPUT);
  digitalWrite(BRAKE_RIGHT_MOTOR, HIGH); // HIGH = BRAKE ACTIVO
  motor_pwm_write(PWM_LEFT_MOTOR, 0);
  motor_pwm_write(PWM_RIGHT_MOTOR, 0);
  
  // Inicializar estados como INHABILITADOS
  leftMotor.enabled = false;   // MOTORES INHABILITADOS al inicio
  rightMotor.enabled = false;  // MOTORES INHABILITADOS al inicio
  leftMotor.stopped = true;    // STOP activo
  rightMotor.stopped = true;   // STOP activo
  leftMotor.braked = true;     // BRAKE activo
  rightMotor.braked = true;    // BRAKE activo
  
  DEBUG_PRINTLN("Pines de motores inicializados - ESTADO ESTÁTICO (INHABILITADOS)");
}

/**
 * FUNCIÓN PARA FORZAR STOP PINS A LOW EN INICIALIZACIÓN
 * Se ejecuta después de la inicialización para garantizar el estado
 */
void forceStopPinsLowInit() {
  pinMode(STOP_LEFT_MOTOR, OUTPUT);
  pinMode(STOP_RIGHT_MOTOR, OUTPUT);
  
  // Forzar múltiples veces para asegurar el estado
  for(int i = 0; i < 3; i++) {
    digitalWrite(STOP_LEFT_MOTOR, LOW);
    digitalWrite(STOP_RIGHT_MOTOR, LOW);
    delay(5);
  }
  
  // Actualizar estados
  leftMotor.enabled = false;
  rightMotor.enabled = false;
  leftMotor.stopped = true;
  rightMotor.stopped = true;
  
  DEBUG_PRINTLN("*** STOP PINS FORZADOS A LOW - MOTORES INHABILITADOS ***");
}

#ifdef ENABLE_OPTO_ENCODERS
void leftOptoISR();
void rightOptoISR();
#endif

/**
 * INICIALIZAR OPTOENCODERS
 */
void initializeOptoEncoders() {
  #ifdef ENABLE_OPTO_ENCODERS
    // Configurar pines de OptoEncoders
    pinMode(OPTO_LEFT_MOTOR, INPUT_PULLUP);
    pinMode(OPTO_RIGHT_MOTOR, INPUT_PULLUP);
    
    // Contar un pulso por cada flanco ascendente.
    attachInterrupt(digitalPinToInterrupt(OPTO_LEFT_MOTOR), leftOptoISR, RISING);
    attachInterrupt(digitalPinToInterrupt(OPTO_RIGHT_MOTOR), rightOptoISR, RISING);
    
    DEBUG_PRINTLN("OptoEncoders inicializados");
  #else
    DEBUG_PRINTLN("OptoEncoders deshabilitados");
  #endif
}

/**
 * FUNCIONES ISR PARA OPTOENCODERS
 * Estas funciones se definen aquí para evitar errores si se referencian
 */
#ifdef ENABLE_OPTO_ENCODERS
// Declaraciones externas para variables de OptoEncoders
extern volatile uint32_t leftOptoCount;
extern volatile uint32_t rightOptoCount;
volatile uint32_t leftOptoLastPulseUs = 0;
volatile uint32_t rightOptoLastPulseUs = 0;
volatile uint32_t leftOptoFilterUs = OPTO_FILTER_US;
volatile uint32_t rightOptoFilterUs = OPTO_FILTER_US;
// Solo para el comando diagnostico q: congela ambos canales con el mismo
// debounce y evita que el Hall del lado logico modifique el canal cruzado.
volatile bool optoDiagnosticFixedFilter = false;
volatile uint8_t optoLeftFilterScalePct = 100; // runtime bench A/B; boot unchanged
volatile uint32_t leftOptoRawEdges = 0;
volatile uint32_t rightOptoRawEdges = 0;
volatile uint32_t leftOptoAccepted = 0;
volatile uint32_t rightOptoAccepted = 0;
volatile uint32_t leftOptoRejected = 0;
volatile uint32_t rightOptoRejected = 0;

uint32_t optoLeftBootstrapFilterForPwm(uint8_t pwm) {
  if (pwm >= 40) return 5600UL;
  if (pwm >= 35) return 6700UL;
  if (pwm >= 30) return 7800UL;
  if (pwm >= 25) return 9800UL;
  if (pwm >= 20) return 12800UL;
  return OPTO_FILTER_MAX_US;
}

uint32_t optoRightBootstrapFilterForPwm(uint8_t pwm) {
  if (pwm >= 40) return 6500UL;
  if (pwm >= 35) return 7500UL;
  if (pwm >= 30) return 8800UL;
  if (pwm >= 25) return 11000UL;
  if (pwm >= 20) return 14000UL;
  return OPTO_FILTER_MAX_US;
}

void leftOptoISR() {
  const uint32_t now = micros();
  leftOptoRawEdges++;
  if ((uint32_t)(now - leftOptoLastPulseUs) >= leftOptoFilterUs) {
    leftOptoCount++;
    leftOptoAccepted++;
    leftOptoLastPulseUs = now;
  } else {
    leftOptoRejected++;
  }
}

void rightOptoISR() {
  const uint32_t now = micros();
  rightOptoRawEdges++;
  if ((uint32_t)(now - rightOptoLastPulseUs) >= rightOptoFilterUs) {
    rightOptoCount++;
    rightOptoAccepted++;
    rightOptoLastPulseUs = now;
  } else {
    rightOptoRejected++;
  }
}
#endif

//===========================================================================
//======================= FUNCIONES BÁSICAS DE MOTORES ====================
//===========================================================================

/**
 * ╔═══════════════════════════════════════════════════════════════════════╗
 * ║  ⚠️  SECCIÓN CRÍTICA - NO MODIFICAR  ⚠️                               ║
 * ╠═══════════════════════════════════════════════════════════════════════╣
 * ║                                                                       ║
 * ║  Las funciones setLeftMotor() y setRightMotor() a continuación       ║
 * ║  están VERIFICADAS y funcionan correctamente.                        ║
 * ║                                                                       ║
 * ║  ❌ NO MODIFICAR LA LÓGICA DE:                                        ║
 * ║     • Dirección (digitalWrite DIR pin)                               ║
 * ║     • PWM (analogWrite PWM pin)                                      ║
 * ║     • STOP (pinMode/digitalWrite STOP pin)                           ║
 * ║     • BRAKE (digitalWrite BRAKE pin)                                 ║
 * ║                                                                       ║
 * ║  ✅ Si un motor va en dirección incorrecta en control PID:           ║
 * ║     → Corregir cinemática diferencial en PID_Control.h               ║
 * ║     → NO tocar Motor_Control.h                                       ║
 * ║                                                                       ║
 * ║  📝 Lógica actual (CORRECTA y VERIFICADA):                           ║
 * ║     • direction=true  → HIGH en DIR → Motor adelante                 ║
 * ║     • direction=false → LOW en DIR  → Motor atrás                    ║
 * ║     • STOP=FLOAT (INPUT) → Motor habilitado                          ║
 * ║     • STOP=LOW (OUTPUT) → Motor deshabilitado                        ║
 * ║     • BRAKE=HIGH → Freno activado                                    ║
 * ║     • BRAKE=LOW → Freno liberado                                     ║
 * ║                                                                       ║
 * ║  📅 Última verificación: 2025-10-12                                  ║
 * ║  ✅ Estado: FUNCIONANDO CORRECTAMENTE                                ║
 * ║                                                                       ║
 * ╚═══════════════════════════════════════════════════════════════════════╝
 */

/**
 * CONFIGURAR MOTOR IZQUIERDO
 */
void setLeftMotor(int pwm, bool direction) {
  // Validar PWM
  pwm = constrain(pwm, 0, MAX_PWM_VALUE);
  
  // Si PWM es muy bajo, detener motor
  if (pwm > 0 && pwm < MIN_PWM_VALUE) {
    pwm = MIN_PWM_VALUE;
  }
  
  #ifdef ENABLE_ADAPTIVE_OPTO_FILTER
  if (leftMotor.pwm == 0 && pwm > 0) {
    leftOptoFilterUs = optoLeftBootstrapFilterForPwm((uint8_t)pwm);
  }
  #endif

  // Actualizar estado
  leftMotor.pwm = pwm;
  leftMotor.direction = direction;
  leftMotor.stopped = (pwm == 0);
  
  // Aplicar configuración al hardware.
  // NOTA: los pines STOP/BRAKE solo se gestionan en setStateHabilitado/Inhabilitado.
  // Aquí solo se aplica DIR y PWM para evitar togglear STOP en cada llamada.
  if (!leftMotor.braked && leftMotor.enabled) {
    digitalWrite(DIR_LEFT_MOTOR, direction ? HIGH : LOW);
    motor_pwm_write(PWM_LEFT_MOTOR, pwm);
  }
  
  lastCommandTime = millis();
  
  DEBUG_PRINT("Motor IZQ: PWM=");
  DEBUG_PRINT(pwm);
  DEBUG_PRINT(" DIR=");
  DEBUG_PRINTLN(direction ? "FWD" : "BWD");
}

/**
 * CONFIGURAR MOTOR DERECHO
 */
void setRightMotor(int pwm, bool direction) {
  // Validar PWM
  pwm = constrain(pwm, 0, MAX_PWM_VALUE);
  
  // Motor derecho: fallback mínimo — el boost proporcional en ros2_processCmdVel
  // ya maneja el caso normal. Aquí solo aplica para comandos directos R/L.
  if (pwm > 0 && pwm < MIN_PWM_RIGHT_WORKING) {
    pwm = MIN_PWM_RIGHT_WORKING;
  }
  
  #ifdef ENABLE_ADAPTIVE_OPTO_FILTER
  if (rightMotor.pwm == 0 && pwm > 0) {
    rightOptoFilterUs = optoRightBootstrapFilterForPwm((uint8_t)pwm);
  }
  #endif

  // Actualizar estado
  rightMotor.pwm = pwm;
  rightMotor.direction = direction;
  rightMotor.stopped = (pwm == 0);
  
  // Aplicar configuración al hardware.
  // NOTA: los pines STOP/BRAKE solo se gestionan en setStateHabilitado/Inhabilitado.
  // Aquí solo se aplica DIR y PWM para evitar togglear STOP en cada llamada.
  if (!rightMotor.braked && rightMotor.enabled) {
    digitalWrite(DIR_RIGHT_MOTOR, direction ? HIGH : LOW);
    motor_pwm_write(PWM_RIGHT_MOTOR, pwm);
  }
  
  lastCommandTime = millis();
  
  DEBUG_PRINT("Motor DER: PWM=");
  DEBUG_PRINT(pwm);
  DEBUG_PRINT(" DIR=");
  DEBUG_PRINTLN(direction ? "FWD" : "BWD");
}

/**
 * CONFIGURAR AMBOS MOTORES SIMULTÁNEAMENTE
 */
void setBothMotors(int leftPwm, bool leftDir, int rightPwm, bool rightDir) {
  setLeftMotor(leftPwm, leftDir);
  setRightMotor(rightPwm, rightDir);
}

/**
 * DETENER AMBOS MOTORES
 */
void stopAllMotors() {
  setBothMotors(0, true, 0, true);
  DEBUG_PRINTLN("Todos los motores detenidos");
}

/**
 * HABILITAR/DESHABILITAR MOTOR IZQUIERDO
 */
void enableLeftMotor(bool enable) {
  leftMotor.enabled = enable;
  
  if (!enable) {
    motor_pwm_write(PWM_LEFT_MOTOR, 0);
    pinMode(STOP_LEFT_MOTOR, OUTPUT);
    digitalWrite(STOP_LEFT_MOTOR, LOW); // LOW = DISABLE motor
  } else {
    pinMode(STOP_LEFT_MOTOR, INPUT);    // FLOAT = ENABLE motor
  }
  
  DEBUG_PRINT("Motor izquierdo ");
  DEBUG_PRINTLN(enable ? "habilitado" : "deshabilitado");
}

/**
 * HABILITAR/DESHABILITAR MOTOR DERECHO
 */
void enableRightMotor(bool enable) {
  rightMotor.enabled = enable;
  
  if (!enable) {
    motor_pwm_write(PWM_RIGHT_MOTOR, 0);
    pinMode(STOP_RIGHT_MOTOR, OUTPUT);
    digitalWrite(STOP_RIGHT_MOTOR, LOW); // LOW = DISABLE motor
  } else {
    pinMode(STOP_RIGHT_MOTOR, INPUT);    // FLOAT = ENABLE motor
  }
  
  DEBUG_PRINT("Motor derecho ");
  DEBUG_PRINTLN(enable ? "habilitado" : "deshabilitado");
}

/**
 * HABILITAR/DESHABILITAR AMBOS MOTORES
 */
void enableAllMotors(bool enable) {
  enableLeftMotor(enable);
  enableRightMotor(enable);
}

/**
 * ACTIVAR/DESACTIVAR FRENO MOTOR IZQUIERDO
 */
void brakeLeftMotor(bool brake) {
  leftMotor.braked = brake;
  
  if (brake) {
    pinMode(BRAKE_LEFT_MOTOR, OUTPUT);
    digitalWrite(BRAKE_LEFT_MOTOR, HIGH);  // HIGH = BRAKE ACTIVO
    motor_pwm_write(PWM_LEFT_MOTOR, 0);
  } else {
    pinMode(BRAKE_LEFT_MOTOR, INPUT);      // FLOAT = BRAKE DESACTIVADO
  }
  
  DEBUG_PRINT("Freno motor izquierdo ");
  DEBUG_PRINTLN(brake ? "activado" : "desactivado");
}

/**
 * ACTIVAR/DESACTIVAR FRENO MOTOR DERECHO
 */
void brakeRightMotor(bool brake) {
  rightMotor.braked = brake;
  
  if (brake) {
    pinMode(BRAKE_RIGHT_MOTOR, OUTPUT);
    digitalWrite(BRAKE_RIGHT_MOTOR, HIGH);  // HIGH = BRAKE ACTIVO
    motor_pwm_write(PWM_RIGHT_MOTOR, 0);
  } else {
    pinMode(BRAKE_RIGHT_MOTOR, INPUT);      // FLOAT = BRAKE DESACTIVADO
  }
  
  DEBUG_PRINT("Freno motor derecho ");
  DEBUG_PRINTLN(brake ? "activado" : "desactivado");
}

/**
 * ACTIVAR/DESACTIVAR FRENOS DE AMBOS MOTORES
 */
void brakeAllMotors(bool brake) {
  brakeLeftMotor(brake);
  brakeRightMotor(brake);
}

//===========================================================================
//==================== FUNCIONES DE MOVIMIENTO BÁSICO ====================
//===========================================================================

/**
 * AVANZAR HACIA ADELANTE
 */
void moveForward(int speed) {
  speed = constrain(speed, 0, MAX_PWM_VALUE);
  setBothMotors(speed, true, speed, false);
  DEBUG_PRINT("Avanzando a velocidad: ");
  DEBUG_PRINTLN(speed);
}

/**
 * RETROCEDER
 */
void moveBackward(int speed) {
  speed = constrain(speed, 0, MAX_PWM_VALUE);
  setBothMotors(speed, false, speed, true);
  DEBUG_PRINT("Retrocediendo a velocidad: ");
  DEBUG_PRINTLN(speed);
}

/**
 * GIRAR A LA IZQUIERDA (DIFERENCIAL)
 */
void turnLeft(int leftSpeed, int rightSpeed) {
  leftSpeed = constrain(leftSpeed, 0, MAX_PWM_VALUE);
  rightSpeed = constrain(rightSpeed, 0, MAX_PWM_VALUE);
  
  setBothMotors(leftSpeed, true, rightSpeed, false);
  
  DEBUG_PRINT("Girando izquierda - IZQ:");
  DEBUG_PRINT(leftSpeed);
  DEBUG_PRINT(" DER:");
  DEBUG_PRINTLN(rightSpeed);
}

/**
 * GIRAR A LA DERECHA (DIFERENCIAL)
 */
void turnRight(int leftSpeed, int rightSpeed) {
  leftSpeed = constrain(leftSpeed, 0, MAX_PWM_VALUE);
  rightSpeed = constrain(rightSpeed, 0, MAX_PWM_VALUE);
  
  setBothMotors(leftSpeed, true, rightSpeed, false);
  
  DEBUG_PRINT("Girando derecha - IZQ:");
  DEBUG_PRINT(leftSpeed);
  DEBUG_PRINT(" DER:");
  DEBUG_PRINTLN(rightSpeed);
}

//===========================================================================
//==================== FUNCIONES DE SEGURIDAD ============================
//===========================================================================

/**
 * VERIFICACIÓN DE SEGURIDAD PERIÓDICA
 */
void motorSafetyCheck() {
  // Si el safety check está deshabilitado, salir
  if (!safetyCheckEnabled) return;
  
  unsigned long currentTime = millis();
  
  // Verificar timeout de comandos
  if (currentTime - lastCommandTime > EMERGENCY_STOP_TIME) {
    emergencyStop();
    DEBUG_PRINTLN("TIMEOUT - Parada de emergencia por falta de comandos");
  }
  
  // Otras verificaciones de seguridad pueden agregarse aquí
}

/**
 * OBTENER ESTADO DE LOS MOTORES
 */
void printMotorStatus() {
  DEBUG_PRINTLN("=== ESTADO DE MOTORES ===");
  
  DEBUG_PRINT("Motor Izquierdo - PWM:");
  DEBUG_PRINT(leftMotor.pwm);
  DEBUG_PRINT(" DIR:");
  DEBUG_PRINT(leftMotor.direction ? "FWD" : "BWD");
  DEBUG_PRINT(" STOP:");
  DEBUG_PRINT(leftMotor.stopped ? "SI" : "NO");
  DEBUG_PRINT(" BRAKE:");
  DEBUG_PRINT(leftMotor.braked ? "SI" : "NO");
  DEBUG_PRINT(" ENABLED:");
  DEBUG_PRINTLN(leftMotor.enabled ? "SI" : "NO");
  
  DEBUG_PRINT("Motor Derecho - PWM:");
  DEBUG_PRINT(rightMotor.pwm);
  DEBUG_PRINT(" DIR:");
  DEBUG_PRINT(rightMotor.direction ? "FWD" : "BWD");
  DEBUG_PRINT(" STOP:");
  DEBUG_PRINT(rightMotor.stopped ? "SI" : "NO");
  DEBUG_PRINT(" BRAKE:");
  DEBUG_PRINT(rightMotor.braked ? "SI" : "NO");
  DEBUG_PRINT(" ENABLED:");
  DEBUG_PRINTLN(rightMotor.enabled ? "SI" : "NO");
  
  DEBUG_PRINT("Último comando hace: ");
  DEBUG_PRINT((millis() - lastCommandTime) / 1000);
  DEBUG_PRINTLN(" segundos");
}

#endif // MOTOR_CONTROL_H
