josemsotov/Smart-trolley-AGO26-arduino-bridge-15/simulation_ws/src/robot_follower/config/follower_params.yaml

robot_follower:
  ros__parameters:
    follow_distance: 2.50
    follow_min_distance: 2.00
    follow_max_distance: 3.00
    min_distance: 0.50
    max_detect_dist: 5.00
    min_angle_deg: 0.0
    search_angle_deg: 60.0
    max_linear_vel: 0.35
    max_angular_vel: 0.60
    kp_linear: 0.70
    kp_angular: 1.00
    approach_distance: 0.50
    approach_tolerance: 0.08
    use_kinect: false
    visual_identity_enabled: true
    visual_identity_required: true
    visual_identity_threshold: 0.62
    visual_identity_timeout: 1.20
    visual_identity_samples: 4
    visual_identity_verify_once: true
    visual_target_fov_deg: 62.0
    person_detection_width: 384
    person_detection_stride: 2
    visual_process_max_hz: 4.0
    person_min_confidence: 0.35
    person_track_timeout: 1.20
    lidar_visual_gate_deg: 14.0
    lidar_camera_yaw_deg: 90.0
    lidar_cluster_jump_m: 0.30
    lidar_min_cluster_points: 3
    lidar_distance_smoothing_alpha: 0.25
    lidar_angle_smoothing_alpha: 0.35
    lidar_max_target_jump_m: 0.60
    lidar_continuity_accept_m: 0.25
    lidar_switch_confirm_scans: 3
    lidar_candidate_match_m: 0.20
    face_distance_scale_m: 0.185
    lidar_face_distance_gate_m: 0.45
    face_distance_timeout: 1.50
    lidar_initial_distance_hint_m: 1.30
    lidar_initial_distance_gate_m: 0.35
    min_linear_vel: 0.06
    linear_deadband: 0.06
    angular_deadband_deg: 2.0
    velocity_smoothing_alpha: 0.28
    target_speed_alpha: 0.25
    target_speed_deadband: 0.04
    early_follow_min_scale: 0.25
    pivot_angle_deg: 18.0
    max_pivot_angular: 0.18
    moving_turn_ratio: 1.50
    gesture_test_linear_vel: 0.14
    gesture_test_angular_vel: 0.30
    gesture_test_duration: 1.00

stadia_node:
  ros__parameters:
    max_linear_vel:      0.40   # m/s — velocidad lineal máxima
    max_angular_vel:     0.70   # rad/s — velocidad angular máxima
    deadzone_lin:        0.12   # zona muerta palanca lineal (0-1)
    deadzone_ang:        0.15   # zona muerta palanca angular (0-1)
    angular_expo:        2.0    # exponente angular (1=lineal, 2=cuadrático)
    smoothing_alpha:     0.35   # suavizado (0=lento, 1=instantáneo)
    send_rate_hz:        20.0   # Hz de publicación en /cmd_vel
    rotation_dominance:  2.0    # ratio para activar modo rotación pura
    rotation_speed_scale: 1.0   # PWM minimo continuo recalibrado a 10
    takeover_on_connect: true   # Bluetooth conectado toma control y detiene follower
    takeover_axis_threshold: 0.25 # movimiento deliberado cancela follower y toma control
    require_neutral_to_arm: false # el Stadia queda armado al conectar; conserva STOP inicial y deadzones
    kinect_tilt_deadzone: 0.20 # zona muerta de la palanca derecha vertical
    kinect_tilt_speed_deg_s: 10.0 # velocidad maxima de inclinacion
    kinect_tilt_command_interval: 0.15 # limita ordenes al motor del Kinect

field_supervisor:
  ros__parameters:
    monitor_only: true
    state_timeout_s: 2.0
    navigation_ready: false
    initial_mode: PAUSE
    gps_min_satellites: 6
    gps_max_hdop: 2.5
    gps_stable_time_s: 10.0

cmd_vel_guard:
  ros__parameters:
    monitor_only: true
    cmd_timeout_s: 0.6
    max_linear: 0.45
    max_angular: 0.90

cmd_vel_mux:
  ros__parameters:
    source_timeout_s: 0.35
    field_timeout_s: 1.5
    max_linear: 0.45
    max_angular: 0.90
    publish_rate_hz: 20.0
