josemsotov/Smart-trolley-AGO26-arduino-bridge-15/simulation_ws/src/robot_follower/config/ekf_gps.yaml

ekf_global_filter:
  ros__parameters:
    frequency: 15.0
    sensor_timeout: 0.5
    two_d_mode: true
    publish_tf: true
    publish_acceleration: false
    print_diagnostics: true
    map_frame: map
    odom_frame: odom
    base_link_frame: base_link
    world_frame: map

    odom0: /odometry/filtered
    odom0_config: [true, true, false,
                   false, false, true,
                   true, false, false,
                   false, false, true,
                   false, false, false]
    odom0_queue_size: 10

    odom1: /odometry/gps
    odom1_config: [true, true, false,
                   false, false, false,
                   false, false, false,
                   false, false, false,
                   false, false, false]
    odom1_queue_size: 10

    imu0: /imu/data_raw
    imu0_config: [false, false, false,
                  false, false, true,
                  false, false, false,
                  false, false, true,
                  false, false, false]
    imu0_queue_size: 20
    imu0_relative: true
    imu0_remove_gravitational_acceleration: false

navsat_transform:
  ros__parameters:
    frequency: 10.0
    delay: 1.0
    magnetic_declination_radians: 0.0
    yaw_offset: 0.0
    zero_altitude: true
    broadcast_cartesian_transform: true
    broadcast_cartesian_transform_as_parent_frame: false
    publish_filtered_gps: true
    use_odometry_yaw: false
    wait_for_datum: false
