josemsotov/Smart-trolley-AGO26-arduino-bridge-15/(commit log)

2026-08-26 Backup PWM completo y correccion Hall 2500us
    [Configuration.h, controller_pwm_profile_20260827.csv, encoder_both_45ppr_full_20260825.csv, encoder_both_full_20260825.csv, encoder_both_full_repeat_20260825.csv, encoder_both_intermediate_20260825.csv, encoder_cross_fixed_swapped_low_20260825.csv, encoder_cross_pwm90_20260825.csv]
2026-08-27 Back up virtual control and FF120 firmware V5
    [Configuration.h]
2026-09-17 Backup robot stack: dual LiDAR UI, TF-Luna firmware, bench tests and handover
    [Configuration.h]
2026-10-02 Add SOTO-ROBOTICS golf trolley portfolio
    Create a dependency-free engineering case study for the Smart Golf Trolley, covering the multidisciplinary prototype architecture, software, electronics, mechanics and validation work.\n\nCo-authored-by: Copilot <223556219+Copilot@users.noreply.github.com>
2026-10-02 Document trolley systems engineering baseline
    Apply the systems-engineering lecture methods to the implemented prototype with traceable interfaces, provisional requirements, safety-function credit and a preliminary hazard log. Align the portfolio and operator visual aid, record the unified Home Assistant deployment, and link the public page to the immutable portfolio-v1.0.0 baseline.\n\nCo-authored-by: Copilot <223556219+Copilot@users.noreply.github.com>
2026-10-05 Back up ELP swing analysis and integrated controls
    Preserve the deployed high-speed ELP recording and live-preview workflow, unified operator interface, control-system analysis, lower-LiDAR reconfiguration, and pending firmware servo integration.
    [Configuration.h]
2026-10-06 Back up calibrated auxiliary servo control
    Preserve the physically validated SG90 profile on pin 38, optional MG996R calibration, non-blocking slew, and automatic signal release. Document the wiring and calibration history and keep Stadia Y routed through the safe STOP sequence.
    [Configuration.h]
2026-10-06 Add safe Pi shutdown control
    Add an operator-confirmed poweroff action that stops the robot, verifies systemd authorization, acknowledges the browser, and then schedules shutdown. Reject missing or invalid confirmation explicitly and document the deployed behavior.
